apullin/zumocrawler/board/zumy_carrier_v01/zumy_carrier_board.brd

## EAGLE design board/zumy_carrier_v01/zumy_carrier_board.brd (2016-03-15)

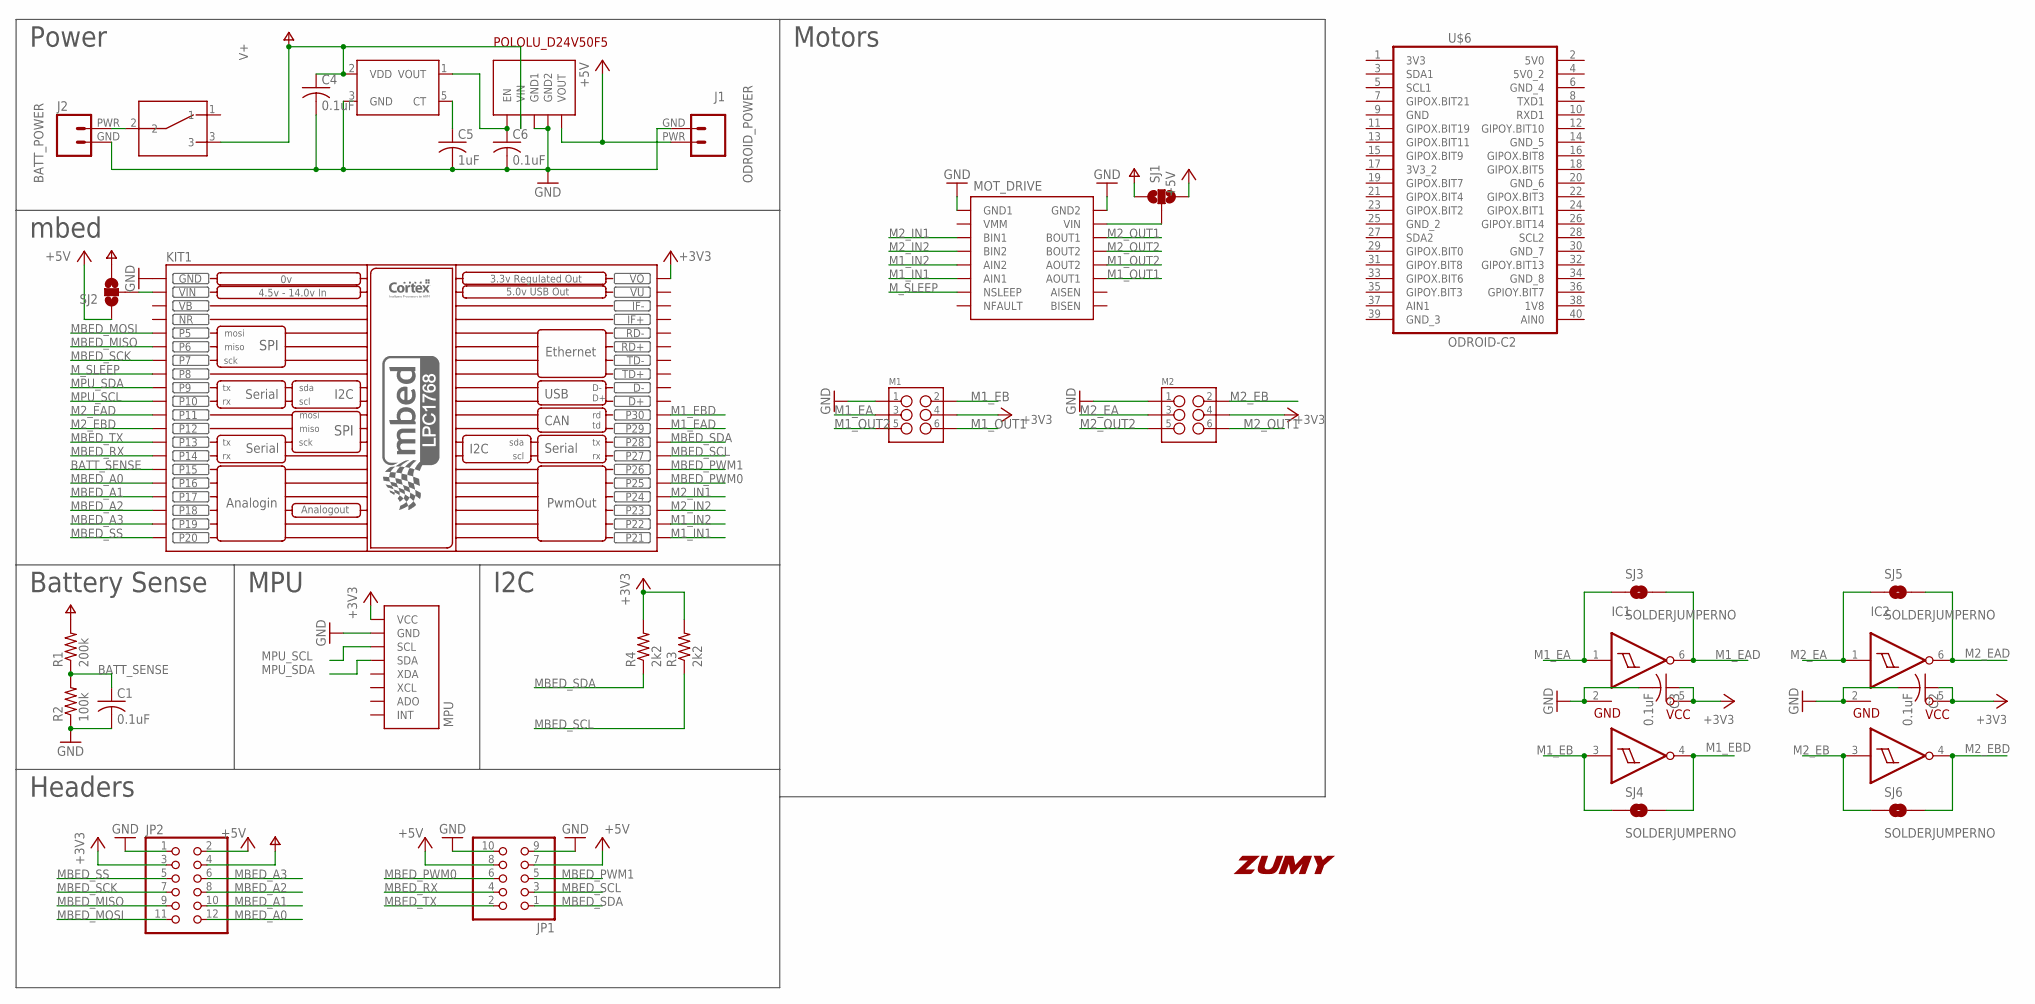
[picture p1: schematic zumy_carrier_board.sch]

Parts:
C1, C2, C3, C4, C6: 0.1uF; C1206
C5: 1uF; C1206
IC1, IC2: SN74AUP2G17; SC-70-6
J1: ODROID_POWER; ODOIRD_PWR
J2: BATT_POWER
JP1: PINHD-2X5; 2X05
JP2: PINHD-2X6; 2X06
KIT1: MBED_NXP_LPC1768; MBED-KIT
M1, M2: M03X2SHROUD; 2X3-SHROUDED
MOT_DRIVE: POLOLU_DRV8833_MODULE
MPU: ITG/MPU_MODULE
R1: 200k; R1206
R2: 100k; R1206
R3, R4: 2k2; R1206
SJ1, SJ2: SOLDERJUMPER_2WAYT; SJ_2
SJ3, SJ4, SJ5, SJ6: SOLDERJUMPERNO; SJ_2S-NO
SW1: 500SSP1S1M6QEA; 500SSP1S1M6QEA_SWITCH
U$2: BD5260G; SOT23-5
U$3: ZUMY_LOGO; ZUMY_LOGO_SILK
U$5: POLOLU_D24V50F5
U$6: ODROID-C2; ODROID-C2-BOARD

Connections:
+3V3: C2.1, C3.1, IC1.5 (VCC), IC2.5 (VCC), JP2.3, KIT1.VOUT (VO), M1.4, M2.4, MPU.VCC, R3.2, R4.2
+5V: J1.PWR, JP1.7, JP1.8, JP2.2, SJ1.3, SJ2.1, U$5.VOUT
BATT_SENSE: C1.1, KIT1.P$15 (P15), R1.1, R2.2
GND: C1.2, C2.2, C3.2, C4.2, C5.2, C6.2, IC1.2 (GND), IC2.2 (GND), J1.GND, J2.GND, JP1.9, JP1.10, JP2.1, KIT1.GND, M1.1, M2.1, MOT_DRIVE.GND1, MOT_DRIVE.GND2, MPU.GND, R2.1, U$2.3 (GND), U$5.GND1, U$5.GND2
M1_EA: IC1.1 (1A), M1.3, SJ3.1
M1_EAD: IC1.6 (1Y), KIT1.P$29 (P29), SJ3.2
M1_EB: IC1.3 (2A), M1.2, SJ4.1
M1_EBD: IC1.4 (2Y), KIT1.P$30 (P30), SJ4.2
M1_IN1: KIT1.P$21 (P21), MOT_DRIVE.AIN1
M1_IN2: KIT1.P$22 (P22), MOT_DRIVE.AIN2
M1_OUT1: M1.6, MOT_DRIVE.AOUT1
M1_OUT2: M1.5, MOT_DRIVE.AOUT2
M2_EA: IC2.1 (1A), M2.3, SJ5.1
M2_EAD: IC2.6 (1Y), KIT1.P$11 (P11), SJ5.2
M2_EB: IC2.3 (2A), M2.2, SJ6.1
M2_EBD: IC2.4 (2Y), KIT1.P$12 (P12), SJ6.2
M2_IN1: KIT1.P$24 (P24), MOT_DRIVE.BIN1
M2_IN2: KIT1.P$23 (P23), MOT_DRIVE.BIN2
M2_OUT1: M2.6, MOT_DRIVE.BOUT1
M2_OUT2: M2.5, MOT_DRIVE.BOUT2
MBED_A0: JP2.12, KIT1.P$16 (P16)
MBED_A1: JP2.10, KIT1.P$17 (P17)
MBED_A2: JP2.8, KIT1.P$18 (P18)
MBED_A3: JP2.6, KIT1.P$19 (P19)
MBED_MISO: JP2.9, KIT1.P$6 (P6)
MBED_MOSI: JP2.11, KIT1.P$5 (P5)
MBED_PWM0: JP1.6, KIT1.P$25 (P25)
MBED_PWM1: JP1.5, KIT1.P$26 (P26)
MBED_RX: JP1.4, KIT1.P$14 (P14)
MBED_SCK: JP2.7, KIT1.P$7 (P7)
MBED_SCL: JP1.3, KIT1.P$27 (P27), R3.1
MBED_SDA: JP1.1, KIT1.P$28 (P28), R4.1
MBED_SS: JP2.5, KIT1.P$20 (P20)
MBED_TX: JP1.2, KIT1.P$13 (P13)
MPU_SCL: KIT1.P$10 (P10), MPU.SCL
MPU_SDA: KIT1.P$9 (P9), MPU.SDA
M_SLEEP: KIT1.P$8 (P8), MOT_DRIVE.NSLEEP
unnamed: KIT1.VIN, SJ2.2
unnamed: J2.PWR, SW1.2
unnamed: MOT_DRIVE.VIN, SJ1.2
unnamed: C6.1, U$2.1 (VOUT), U$5.EN
unnamed: C5.1, U$2.5 (CT)
NR: KIT1.NR
V+: C4.1, JP2.4, R1.2, SJ1.1, SJ2.3, SW1.3, U$2.2 (VDD), U$5.VIN
VB: KIT1.VB
VU: KIT1.VU

Notes on the sheet:
Motors
Power
mbed
MPU
I2C
Headers
Battery Sense

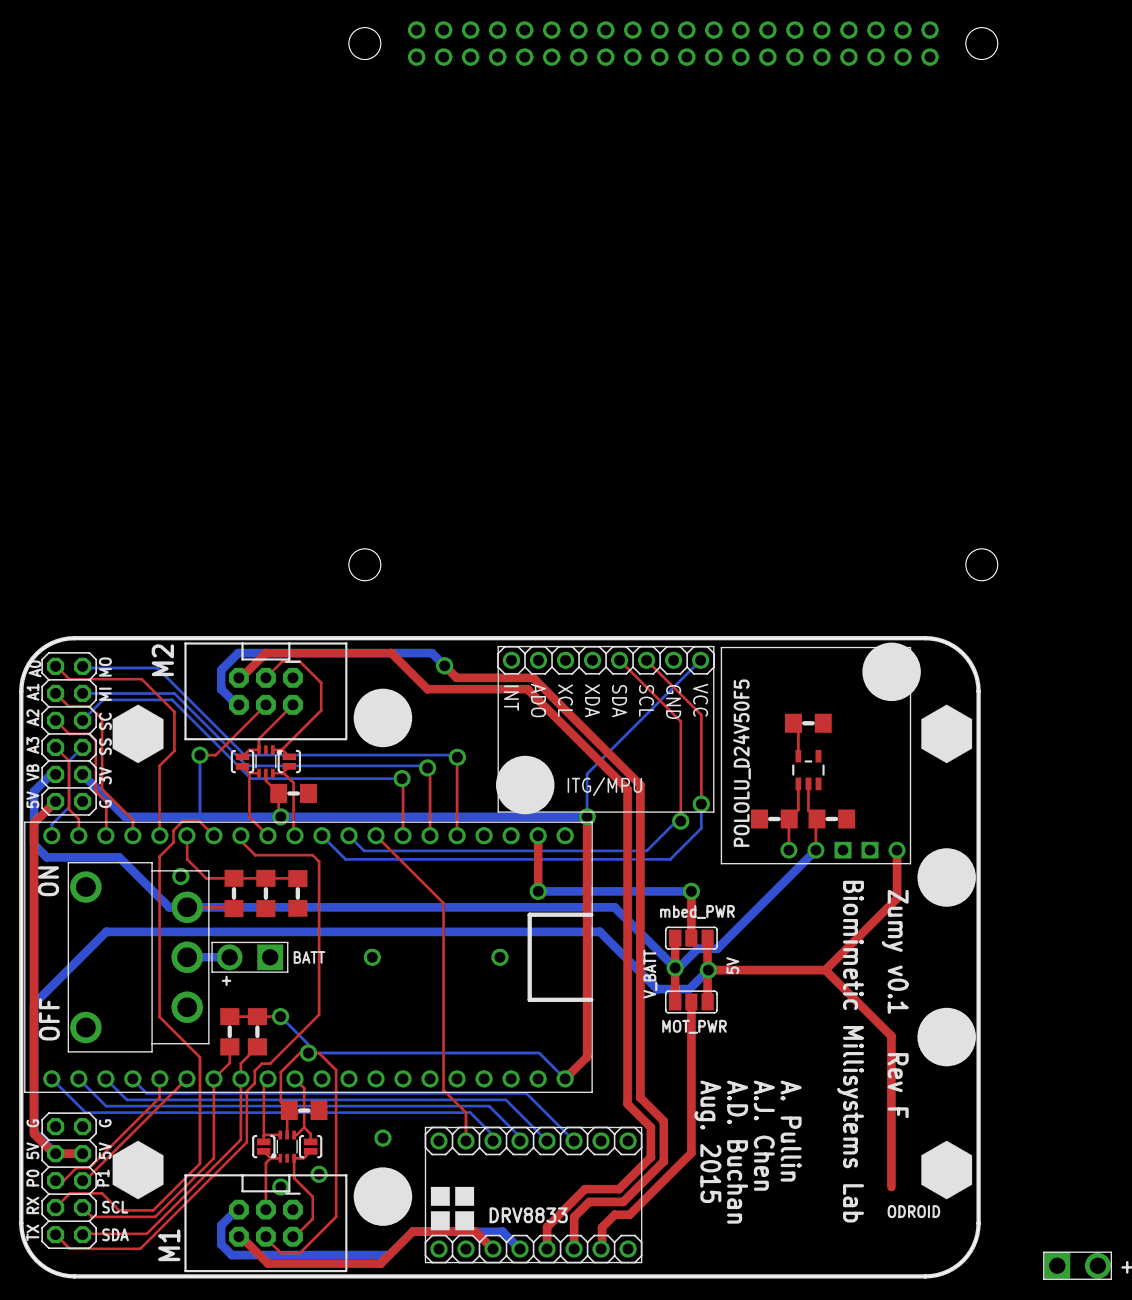
[picture p2: board zumy_carrier_board.brd from above]

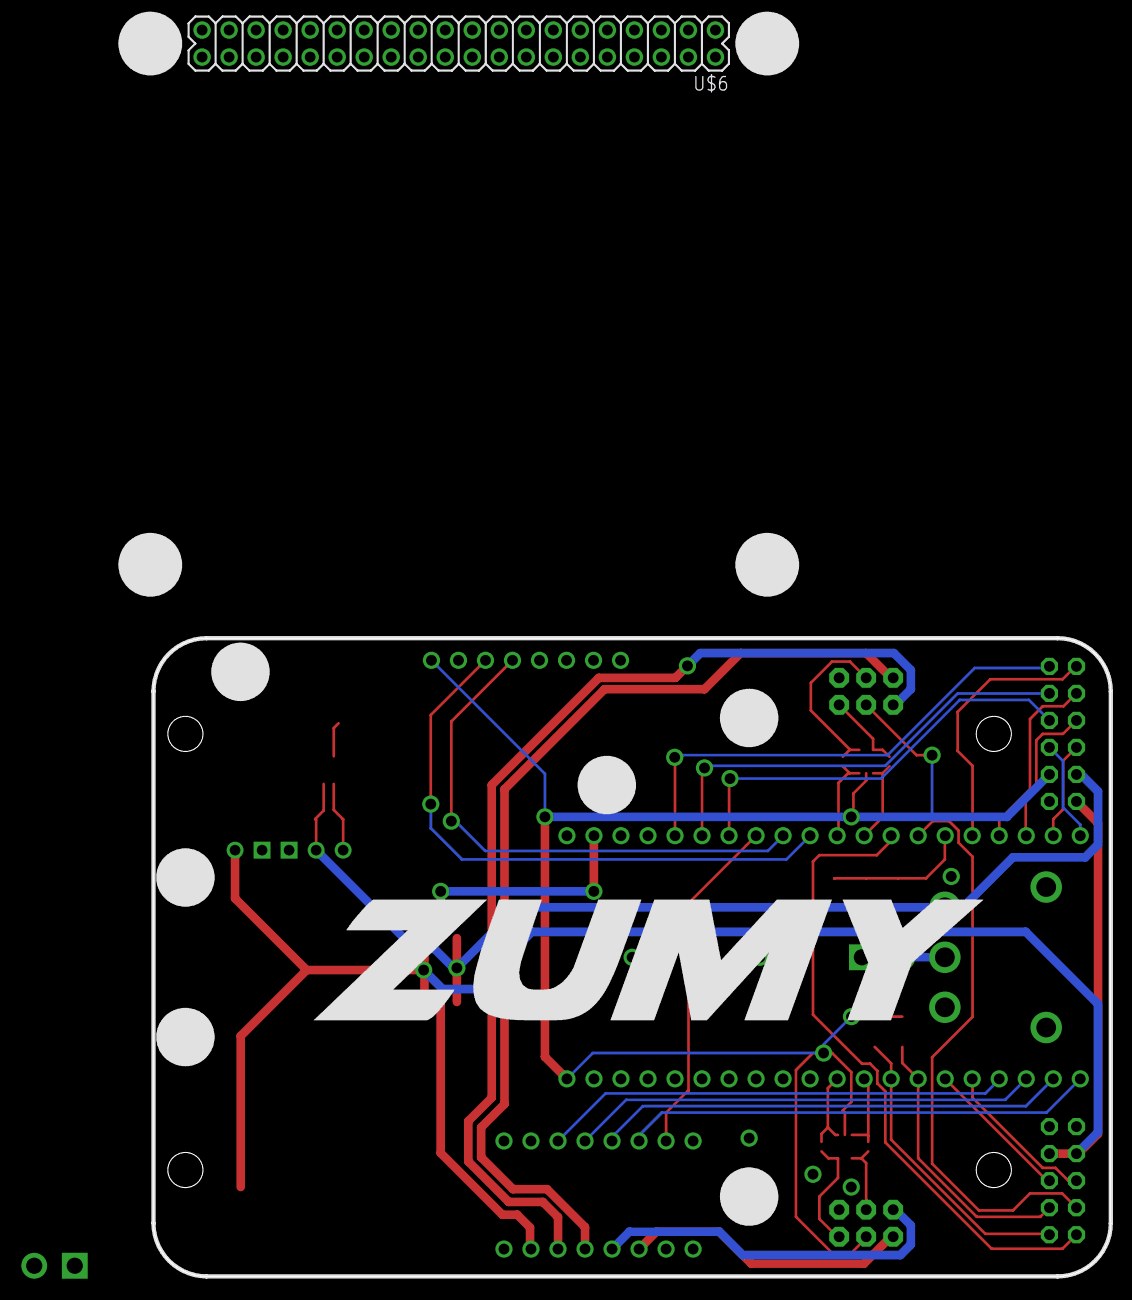
[picture p3: board zumy_carrier_board.brd from below]

Board: 2 copper layers, 90.0 x 60.0 mm, 34 parts (2 on the bottom side), 43 nets.

Other parts of the board:
U$1: CHASSIS_STANDOFF
U$4: ODROID_U3_MOUNTING
