apullin/zumocrawler/board/zumy_carrier_v01/voltage_monitor.brd

## EAGLE design board/zumy_carrier_v01/voltage_monitor.brd (2015-08-28)

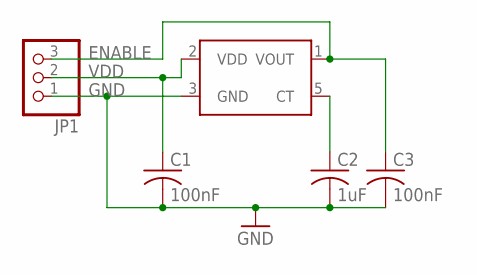
[picture p4: schematic voltage_monitor.sch]

Parts:
C1, C3: 100nF; C1206
C2: 1uF; C1206
JP1: PINHD-1X3; 1X03
U$1: BD5260G; SOT23-5

Connections:
ENABLE: C3.1, JP1.3, U$1.1 (VOUT)
GND: C1.2, C2.2, C3.2, JP1.1, U$1.3 (GND)
unnamed: C2.1, U$1.5 (CT)
VDD: C1.1, JP1.2, U$1.2 (VDD)

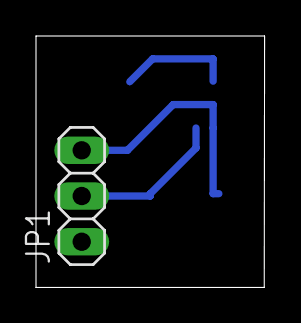
[picture p5: board voltage_monitor.brd from above]

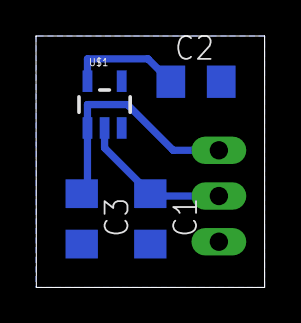
[picture p6: board voltage_monitor.brd from below]

Board: 2 copper layers, 12.7 x 14.0 mm, 5 parts (4 on the bottom side), 4 nets.
