apullin/zumocrawler/(commit log)

2014-08-27 Start of Rev D board. Currently all ripped up.
    [zumy carrier board.brd, zumy carrier board.sch]
2014-08-28 Most of Rev D done. Major rearrangement. New mounting hole pattern.
    [zumy carrier board.brd, zumy carrier board.sch]
2014-08-29 Rev D done. Some library parts updated to suit new layout.
    [zumy carrier board.brd, zumy carrier board.sch]
2014-08-30 Minor adjustments to placement.
    [zumy carrier board.brd]
2014-09-03 Added 6pin shrouded connectors for pololu encoder + motor drive. Routing is all screwed up.
    [zumy carrier board.brd, zumy carrier board.sch]
2014-09-09 Rev D now with encoder connectors, fully routed, no DRC errors.
    [zumy carrier board.brd, zumy carrier board.sch]
2014-09-10 Rev D routed with schmitt triggers on encoders.
    [zumy carrier board.brd, zumy carrier board.sch]
2014-09-15 Updates to labels, placements, layers, etc.
    [zumy carrier board.brd]
2014-09-15 Further minor changes to labels in tplace to enforce no line width < 0.006"
    [zumy carrier board.brd]
2015-06-13 Adding example image of board.
2015-08-10 Added Rev. E Parts (5V Reg with UVLO, Cap on vsense, caps on level translators). Before ripup and rearrange.
    [zumy carrier board.brd, zumy carrier board.sch]
2015-08-11 Schematic and part placement mostly done. Need to clean up schematic, then fine adjust layout, then ready for routing.
    [zumy carrier board.brd, zumy carrier board.sch]
2015-08-11 First pass at layout done
    [zumy carrier board.brd, zumy carrier board.sch]
2015-08-11 Ready to Test on Othermill
    [zumy carrier board.brd]
2015-08-12 Pulled back switch from edge, just need to fix silkscreen.
    [zumy carrier board.brd, zumy carrier board.sch]
2015-08-12 moved a few more traces. still need to do silkscreen.
    [zumy carrier board.brd]
2015-08-12 Silkscreen done, need to clean up for panelization
    [zumy carrier board.brd, zumy carrier board.sch]
2015-08-12 Rename to use underscores.
    [zumy_carrier_board.brd, zumy_carrier_board.sch]
2015-08-28 Adding voltage monitor breakout board.
    [voltage_monitor.brd, voltage_monitor.sch, zumy_carrier_board.brd, zumy_carrier_board.sch]
2015-08-29 Finishing touches for Rev. F. Moved voltage regulator to not conflict with mbed USB cable. Added support post holes for accelerometer and voltage regulator. Increased drill for battery and odroid pow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
    [zumy_carrier_board.brd, zumy_carrier_board.sch]
2016-03-15 Starting to shuffle board around for ODROID-C2 update.
    [zumy_carrier_board.brd, zumy_carrier_board.sch]
